MohitSheth10/Rail-Guard/presentations/README.md

# Presentations

This folder contains the presentation material used to explain Rail-Guard.

The main presentation is the project pitch deck: [`Rail-Guard_Pitch_Deck - Final.pptx`](Rail-Guard_Pitch_Deck%20-%20Final.pptx).

It gives the shorter version of the project: the problem, the idea, the prototype, the experiment and what I am trying to find out.
