MohitSheth10/Rail-Guard/media/README.md

# Media

Photos and videos from the Rail-Guard build and testing.

## Folders

- [`photos/`](photos/) — fabrication, electronics, assembly and experiment photos
- [`videos/`](videos/) — testing and prototype videos

This folder is meant to show what the project actually looked like while it was being built, not just the final setup.
