MohitSheth10/Rail-Guard/report/Rail-Guard_Project_Report.docx

RAIL-GUARD

A Vibration-Based Detector for Loose Railway Fishplate Bolts

Project Report

Mohit Sheth · Dhirubhai Ambani International School, Mumbai

IBDP Research and Engineering Project

Everything in this report was actually built, actually soldered, and actually run: a single instrumented rail-fishplate joint, an accelerometer, and a threshold-based frequency-ratio classifier that calls the joint TIGHT or LOOSE from its vibration signature alone. Earlier planning material for this project, proposed in May 2026, sketched a bigger system: multiple sensors, a load cell, GPS tagging, a cloud dashboard. None of that has been built or tested yet; Results and Conclusion covers it as future scope, not as a result. If a claim appears in these pages, hardware ran it and data backs it.

01 · PROBLEM STATEMENT

What is a fishplate?

A fishplate, also called a joint bar, is a flat steel plate bolted across the joint where two rail lengths meet, holding the rail ends in line so a wheel can cross the gap without dropping. A standard joint uses two of them, one on each side of the rail web, four bolts apiece: eight bolts holding the joint together. Let those bolts back off and the two rail ends start moving independently: the gap widens, alignment goes, and every wheel that crosses the joint drifts the joint a little further apart.

On older jointed track, a fishplate joint shows up roughly every 25 metres, about 40 per kilometre. Modern Continuously Welded Rail removes most of them, though they're still common at bridge approaches, level crossings, station throats, and the rural branch lines that never got upgraded.

~68,000 km Indian Railways total route network (2023-24) | 33.89% of 1,024 Indian derailments (2018-21) caused by track defects — CAG, 2022 | ~40/km fishplate joints on standard 25 m jointed track

Why this matters: Track defects are the single largest cause of derailment in India

The Comptroller and Auditor General of India's 2022 performance audit, Report No. 22 of 2022 — Derailment in Indian Railways, examined 1,024 derailments between 2018 and 2021. Track defects caused 347 of them: 33.89%, the largest single category, ahead of human error at 29.79% and rolling-stock failure at 26.56%. Zoom into the 422 cases the audit pinned on the Engineering Department specifically, and "maintenance of track" tops the list at 171 cases, more than any other single reason. That's the target for this project: the most common failure mode on the railway network, and one today's inspection routine cannot catch early.

Why bolts loosen: the physics behind the problem

A bolted joint doesn't need to be struck to loosen; vibration alone does the job. German engineer Gerhard Junker proved this experimentally in 1969: his paper, "New Criteria for Self-Loosening of Fasteners Under Vibration" (SAE Transactions, vol. 78), showed that transverse vibration — load applied sideways across a joint, exactly the direction a passing wheel loads a fishplate — loosens fasteners far more severely than vibration running along the bolt's own axis. The paper is still the reference test mechanical engineers use to rate how vibration-resistant a fastener is, and every train that crosses a joint applies that same sideways load, thousands of times over the joint's life, which is why fishplate bolts loosen at all and a sensor mounted on the joint can pick it up.

How loose bolts are found today

A track inspector, called a Keyman, walks the line carrying a hammer, stopping at every joint to tap each bolt individually. A properly tightened bolt rings; a loose one thuds. On foot, over ballast, in the open, an inspector covers roughly 4–6 km in a shift. The method works, but it's exhaustive rather than targeted: there's no way to know in advance which bolt is loose, so the overwhelming majority checked in a shift turn out to be perfectly fine. On a network the size of India's, one inspector needs weeks to cover even a modest stretch once, and a bolt can start loosening long before that.

What loosening actually looks like — a short clip of the joint on this project's bench rig, shaken by motor-driven vibration with the fishplate bolts progressively backed off, is linked from the project's code and data repository: bolt-loosening-vibration-demo.mp4 (https://github.com/MohitSheth10/Rail-Guard/blob/main/media/videos/bolt-loosening-vibration-demo.mp4)

02 · RESEARCH QUESTION AND HYPOTHESIS

Research question

Can the vibration signature of a bolted rail fishplate joint, captured with a low-cost MEMS accelerometer and analysed in the frequency domain, reliably distinguish a securely tightened joint from one that is not, automatically, without a person inspecting the joint?

Hypothesis

Shake a bolted joint with a repeatable external vibration source, and the way vibration energy splits across frequency bands, specifically the balance between a lower band and a higher band, should differ measurably between a securely tightened joint (3–4 of 4 bolts tight) and one that isn't (0–2 bolts, or no fishplate at all). A loose joint has more freedom to move: that damps the higher-frequency response and pushes energy down into the lower band. A tight joint, more rigidly coupled, does the opposite.

03 · ENGINEERING GOAL

Build a working bench-scale system that:

- Physically reproduces a real bolted fishplate joint under controlled, repeatable vibration — a motor-driven mechanism standing in for a passing train — rather than relying on simulation alone.
- Samples the joint's vibration fast enough, and cleanly enough, to resolve the frequency content that actually matters, not just overall shake strength.
- Finds a single, well-separated numerical threshold that calls a joint TIGHT or LOOSE from that vibration data, validated against a controlled dataset covering every bolt count from 0 to 4, plus a no-fishplate and a stationary baseline.
- Runs that same classification live, on the real-time serial stream from the sensor, with an immediate TIGHT/LOOSE readout — not only after the fact on a saved recording.

This stays a bench-scale prototype, not a deployed railway system. Proving the detection principle on real hardware was the goal, not shipping a field-ready device.

04 · METHODOLOGY

4.1 — Building a real joint to test on

The project built one real bolted fishplate joint rather than simulate one, because no simulation can show whether real hardware, real bolt threads, and real vibration behave the way the theory predicts. Model railway track is moulded plastic, and structural I-beams aren't shaped like a rail either, so the rail sections came from 2-inch mild-steel T-section with a flat plate welded along the top to form the rail head. That weld left the cross-section asymmetric (the top plate is narrower than the base), a detail that turns out to matter for the physics in section 4.2.

The joint sits on a plywood base. A motor-and-cart mechanism provides repeatable, controlled vibration in place of a passing train, so the same event repeats identically across every bolt-count test.

Electronics actually used

- ESP32-S3 Zero as the controller
- MPU-6050/6500 accelerometer reading the joint's vibration
- L298N motor driver, driving the vibration source
- HX711 amplifier and load cell, soldered onto the rig for future bolt-force sensing — wired in, but not yet exercised in the results reported here

Everything was soldered onto perfboard rather than left on breadboard jumpers, because loose jumper wires and a vibration rig do not mix.

Scope note: this build meets the loose-bolt detection goal the project set out to test. One piece stays open: over-tightening detection. The HX711 load cell is soldered onto the rig and waiting on calibration, which is the project's future scope.

4.2 — The physics first: why the original plan didn't work

Before any detection code got written, one question had to be answered first: what frequency does this rail section actually resonate at, and can the sensor even see it? Getting that wrong would have wasted everything that followed, so the physics came before the firmware.

The rail's cross-section is asymmetric, so the standard symmetric I-beam formula doesn't apply: the neutral axis isn't at mid-height. Splitting the section into three rectangles and finding the area-weighted centroid places it 21.4 mm above the bottom, about 7 mm lower than the section's geometric mid-height of 28.4 mm. The second moment of area follows from there: each rectangle sits a different distance from the true centroid, so the parallel-axis theorem applies, giving I = 166,448 mm⁴.

λ² _________________

f = ───── × √ EI / (m·L⁴)

2π

For mild steel (E = 200 GPa, ρ = 7,850 kg/m³), across the spans and end conditions relevant to this rig, that works out to a fundamental natural frequency somewhere between roughly 168 Hz (the whole 609.6 mm track, cantilevered) and about 38 kHz (a single 101.6 mm sleeper-to-sleeper span, clamped at both ends). The most physically realistic case, the whole track simply supported, lands around 470 Hz.

That range mattered because the MPU's accelerometer samples at 1,000 Hz maximum. By the Nyquist limit, it can resolve frequencies only up to about 500 Hz, and realistically less. Almost every case in that range sits above what the sensor can actually see. Pointing an FFT at the rail's own ringing frequency would have meant either seeing nothing real, or aliasing: a plausible-looking low frequency with no physical meaning behind it.

That finding redirected the whole approach: instead of watching for a shift in the rail's own resonant frequency, the target became the joint itself, the fishplate, bolts, and base moving together as a much heavier, much lower-frequency system. A loose bolt doesn't change the stiffness of the steel rail; it changes how the two rail ends move against each other, and that's a low-frequency signal a 1 kHz accelerometer can resolve without trouble, which is what every step from here builds on.

4.3 — The code, step by step

The firmware and analysis tools were built incrementally, each one solving the specific problem the previous one exposed, ending at the live tool this project currently runs.

Step | File | What it solved
1 | MPU_Test.ino | First proof the sensor was talking to the board, and confirmed its real identity: an MPU-6500 sold under the MPU-6050 name, which needed its own register configuration.
2 | mpu6050_1khz_stream.ino | Correct 1 kHz sampling: moved the sensor to its final wiring, configured the correct MPU-6500 registers, and used an absolute-deadline scheduler so every sample lands within microseconds of its ideal interval.
3 | daq.py | Gets the stream onto a computer — opens the serial port, auto-detects the column count, writes a timestamped CSV.
4 | fft_analysis.py | Turns raw samples into frequency content — trims to the vibrating segment, runs a windowed FFT, reports energy by frequency band.
5 | classify_tightness.py | Applies the tuned 30–60 Hz / 60–100 Hz ratio (section 4.4) to call a reading TIGHT or LOOSE.
6 | statistical_analysis.py | Checks the separation is a real, group-level effect — ANOVA, Kruskal-Wallis, and pairwise tests across every bolt count.
7 | liveclassifytightness.py | The current, final tool: reads the live serial stream, keeps a rolling 2-second window, and re-runs the same tuned classification twice a second in an on-screen GUI.

4.4 — The differentiator: a frequency-band ratio, not raw loudness

The most important decision in this project's methodology was which number to pull out of the FFT and threshold on. Three candidates went up against the full dataset, and two failed:

- Overall vibration loudness (RMS) alone is not reliable. A completely missing fishplate can read about as quiet as a properly tightened joint.
- "Which single frequency is loudest" is not reliable either. Most readings contain two frequencies close in strength, and which one comes out marginally louder can flip between otherwise-identical readings.
- What holds up: the ratio of vibration energy in the 30–60 Hz band to energy in the 60–100 Hz band.

ratio = (energy in 30–60 Hz band) / (energy in 60–100 Hz band)

A securely tightened joint is more rigidly coupled and puts most of its shake into the faster ~79 Hz component, so this ratio comes out low. A joint that isn't properly secured has more freedom to move: that damps the higher-frequency response and leaves relatively more energy in the slower ~39 Hz component, so the ratio comes out high. Raw loudness and a single peak frequency both failed the test, which is why that bandwidth ratio is what the whole detection system is built on.

4.5 — A mounting fix along the way

The plywood base itself was shifting slightly under its own vibration, so part of what the sensor picked up was rig movement, not the joint. Clamping the board down on 29 August fixed it, and every reading used in the results below was collected after that.

05 · OBSERVATION

Once the board-drift bug was fixed, the controlled dataset came together: 0, 1, 2, 3, and 4 bolts tight, plus a no-fishplate condition and a stationary motor-off baseline, three repeats each.

Condition | Ratio range observed | Verdict
4 bolts tight | 0.175 – 0.278 | TIGHT
3 bolts tight | 0.285 – 0.298 | TIGHT
2 bolts tight | 0.386 – 0.466 | LOOSE
1 bolt tight | 0.498 – 0.645 | LOOSE
0 bolts tight / no fishplate | 1.384 – 5.592 | LOOSE

- Every 3–4 bolt (secure) reading scored below 0.30. Every not-secure reading (0–2 bolts, or no fishplate) scored above 0.38 — a clean gap, with the working threshold set at 0.35, in the middle of it.
- Vibrating readings consistently scored well above ~6,000 RMS; a stationary, motor-off reading scored around 36 RMS. Three orders of magnitude apart, plenty of room for a simple RMS floor to flag "not enough vibration to judge" before any TIGHT/LOOSE call gets attempted.

The statistical check confirms the separation is real and group-level, not coincidence, though it's honest about what only three repeats per bolt count can prove: with n = 3 per group, a pairwise Mann-Whitney U test mathematically cannot clear a p-value of 0.1, however separated the groups actually are — a limit of the sample size, not of the method. The overall pattern makes the stronger case anyway: group means ordered 0 > 1 > 2 > 3–4, with little to no overlap in ranges.

Fine-grained bolt counting — telling 3 tight apart from 4 tight, specifically — is noticeably less reliable than the binary TIGHT/LOOSE call: the observed ranges for those two states (0.285–0.298 vs. 0.175–0.278) almost overlap, so the classifier reports them together as a combined "3–4 bolts tight" bucket rather than guessing which one it is.

06 · RESULTS AND CONCLUSION

The hypothesis holds: the ratio of vibration energy between the 30–60 Hz and 60–100 Hz bands reliably separates securely tightened rail-joint bolts from joints that aren't secure, and the working threshold of 0.35 has correctly classified every reading collected to date, whether run offline on saved captures or live on the sensor's real-time stream. That meets the project's engineering goal: a single instrumented joint, detecting loose fishplate bolts automatically, from vibration alone, live and on demand.

One open boundary

The 3-vs-4-tight boundary sits closer together than the rest of the scale (0.285–0.298 vs. 0.175–0.278) and would benefit from more repeat readings before it's trusted at that resolution. The binary TIGHT/LOOSE call is the project's core result, and it isn't affected.

Status

Part | Status
ESP32-S3 controller | Tested
MPU accelerometer | Tested, sampling verified at 1 kHz
Motor + L298N driver | Tested — vibration source confirmed across every capture
Natural-frequency calculation | Done — the result that redirected the whole approach
Board-drift systematic error | Found and fixed (29 August)
Controlled dataset | Collected: 0–4 bolts tight, no-fishplate, stationary baselines, 3 reps each
FFT + tight/loose analysis | Built and statistically checked against the full dataset
Fine-grained bolt count (3 vs 4 tight) | Works; resolution close — more repeats would firm it up
Live real-time detection | Built and working
HX711 + load cell (over-tightening detection) | Soldered, not yet calibrated — the project's future scope

Scope and limits

This stays a bench-scale prototype, validated on one instrumented joint under motor-driven vibration rather than a moving train. Over-tightening detection through the HX711 load cell is wired and soldered; calibrating and testing it is the one piece of the original design still open, and the project's future scope.

Sources

Comptroller and Auditor General of India, Report No. 22 of 2022 — Performance Audit on Derailment in Indian Railways, 2022.

Junker, G. H., "New Criteria for Self-Loosening of Fasteners Under Vibration," SAE Transactions, vol. 78, 1969, pp. 314–335.

Indian Railways route network figures — official Ministry of Railways annual statistics, 2023–24.

Full source code, capture data, and build documentation: github.com/MohitSheth10/Rail-Guard
