MohitSheth10/Rail-Guard/hardware/track_3d_model.html

## Rail-Guard Track — 3D Design (v3)

Drag to rotate · scroll to zoom · right-drag to pan. Yellow labels in the scene show real lengths.

### Confirmed by you

- Each rail = 2 I-section pieces, 12in (1ft) each = 24in (2ft) total track length
- Web height: 2 in · Bottom flange width: 2 in
- Top flange (cart rides here): 2.1 cm ≈ 0.83 in
- Fishplate: 4 in long, as thin as possible
- Sleeper spacing: ~4 in (a bit more/less is fine)
- Gauge (distance between the 2 rails): 4.25 in
- Bolts: 4 in a single horizontal line, in pairs (. . . .), gap in the middle reserved for the MPU sensor mount (green outline)

### Still assumed — please confirm

- Flange thickness: assumed 0.12 in (~3mm)
- Web thickness: assumed 0.1 in (~2.5mm)
- Fishplate thickness: assumed 0.06 in (~1.5mm, thinnest practical sheet steel)
- Fishplate height: assumed 1.8 in (slightly less than web height)
- Motor compartment (70x50x50mm box) is illustrative only

Rail-Guard — track design v3
