MohitSheth10/Rail-Guard/presentations/Rail-Guard_Pitch_Deck - Final.pptx

RAIL-GUARD

A Vibration-Based Detector for Loose Railway Fishplate Bolts

Bench-scale prototype · built and tested on real hardware

Mohit Sheth · Dhirubhai Ambani International School, Mumbai
IBDP Research and Engineering Project · IRIS / INSEF Submission
Updated September 2026

## Slide 2

01 · PROBLEM

A fishplate joint can loosen — and nobody knows until it fails

A fishplate (joint bar) bolts two rail ends together, 4 bolts per side, 8 per joint. Let those bolts back off and the rail ends move independently under every wheel that crosses. Trains loosen them through vibration alone: Junker's 1969 research found that transverse vibration, exactly the load a passing wheel applies, self-loosens bolted joints far more severely than vibration running along the bolt's own axis.

8

bolts hold each fishplate joint together

~40/km

fishplate joints on standard 25 m jointed track

33.89% of the 1,024 derailments India's Comptroller and Auditor General examined (2018–21) were caused by track defects — the single largest category, ahead of human error (29.79%) and rolling-stock failure (26.56%). Within the cases attributed to the Engineering Department, "maintenance of track" was the leading cause of all.

Source: Comptroller and Auditor General of India, Report No. 22 of 2022 — Derailment in Indian Railways.

Rail-Guard — Project Report Deck

2

## Slide 3

01 · PROBLEM

Checking every bolt to find the few that matter

A track inspector, called a Keyman, walks the line with a hammer, tapping every bolt at every joint by hand. A properly tightened bolt rings; a loose one thuds. The method works, but there's no way to know in advance which bolt is loose, so almost every one checked in a shift turns out fine.

Rail-Guard's goal: replace hand-tapping every bolt with a sensor that reads the joint's own vibration and calls it TIGHT or LOOSE automatically.

What loosening actually looks like — bench rig under motor-driven vibration

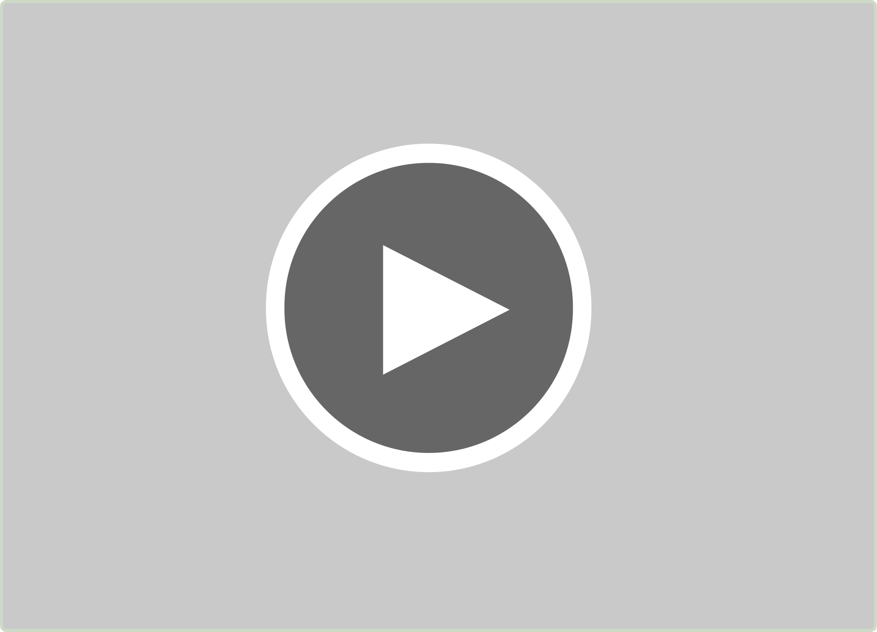
[picture p6: figure]

~68,000 km

Indian Railways total route network (2023–24)

Rail-Guard — Project Report Deck

4–6 km

covered per inspector, per shift, on foot

3

## Slide 4

02 · RESEARCH QUESTION

Research question

Can the vibration signature of a bolted rail fishplate joint, captured with a low-cost MEMS accelerometer and analysed in the frequency domain, reliably distinguish a securely tightened joint from one that is not, automatically, without a person inspecting the joint?

Hypothesis

A loose joint has more freedom to move: that damps the higher-frequency response and pushes relatively more vibration energy into the lower-frequency band, while a tight joint, more rigidly coupled, does the opposite — which is why the balance of energy between a low band and a high band should separate TIGHT joints from LOOSE ones.

Engineering goal: build a bench-scale system that physically reproduces a real bolted joint under controlled vibration, finds a single numerical threshold that separates TIGHT from LOOSE, and runs that classification live on real hardware, as it happens.

Rail-Guard — Project Report Deck

4

## Slide 5

03 · THE BUILD

One real joint, built to actually test the theory

The track section came from 2-inch mild-steel T-section, since model track and structural I-beams don't match a real rail's shape, with one real bolted fishplate joint. A motor-and-cart rig stands in for a passing train, providing repeatable vibration.

Electronics actually used

Scope note

This build completes the loose-bolt detection goal the project set out to test.

The one piece still open: over-tightening detection. The HX711 load cell is soldered onto the rig but not yet calibrated — the project's future scope.

- ESP32-S3 Zero — controller

- MPU-6050/6500 accelerometer — reads joint vibration

- L298N motor driver — drives the vibration source

- HX711 + load cell — soldered in for future bolt-force sensing, not yet exercised in these results

Rail-Guard — Project Report Deck

5

## Slide 6

04 · METHOD

The differentiator: a frequency-band ratio, not raw loudness

Overall vibration loudness isn't reliable, since a missing fishplate can read as quiet as a tight one, and the single loudest frequency isn't reliable either. What holds up: the ratio of vibration energy in a lower band to a higher band.

ratio = (energy in 30–60 Hz band) / (energy in 60–100 Hz band)

A securely tightened joint is more rigidly coupled and puts most of its shake into the faster ~79 Hz component, so the ratio comes out low. A joint that isn't secure has more freedom to move: that damps the higher-frequency response and leaves more energy in the slower ~39 Hz component, so the ratio comes out high.

Mounting fix along the way: the plywood base was shifting under its own vibration. Found and fixed on 29 August; every reading used in the results shown here was collected after that fix.

Rail-Guard — Project Report Deck

6

## Slide 7

05 · RESULTS

A clean separation between TIGHT and LOOSE

Condition | Ratio range observed | Verdict
4 bolts tight | 0.175 – 0.278 | TIGHT
3 bolts tight | 0.285 – 0.298 | TIGHT
2 bolts tight | 0.386 – 0.466 | LOOSE
1 bolt tight | 0.498 – 0.645 | LOOSE
0 bolts / no fishplate | 1.384 – 5.592 | LOOSE

Honest limit: with only 3 repeats per bolt count, a pairwise significance test can't mathematically clear p < 0.1, however separated the groups actually are — a limit of the sample size, not of the method. The group means still order cleanly: 0 > 1 > 2 > 3–4, with little to no overlap in ranges.

Working threshold

0.35

Every 3–4 bolt reading scored below 0.30; every 0–2 bolt (or no-fishplate) reading scored above 0.38 — a clean gap, with the threshold set in the middle of it.

Rail-Guard — Project Report Deck

7

## Slide 8

06 · STATUS

Goal met, with one boundary still open

Result

The core TIGHT/LOOSE distinction, live, on real hardware, across every bolt count from 0 to 4 plus a no-fishplate condition, with a clean statistical gap. The project's engineering goal is met.

One open boundary

The 3-vs-4-tight boundary sits closer together than the rest of the scale and would benefit from more repeats. The binary TIGHT/LOOSE call is the project's core result, and it isn't affected.

Part | Status
ESP32-S3 + MPU accelerometer | Tested, live at 1 kHz
Natural-frequency calc + board-drift fix | Done — redirected the approach; fixed 29 Aug
FFT + tight/loose ratio classifier | Built, statistically checked, running live
HX711 + load cell (over-tightening) | Soldered, not yet calibrated — future scope

Rail-Guard — Project Report Deck

8

## Slide 9

Rail-Guard detects loose fishplate bolts, live, on real hardware.

Bench-scale prototype, single instrumented joint, threshold-based frequency-ratio detection — built, tested, and running.

Thank you

Full source code, capture data, and build documentation:
github.com/MohitSheth10/Rail-Guard

Sources: CAG Report No. 22 of 2022 · Junker (1969), SAE Transactions vol. 78 · Indian Railways route network statistics, 2023–24.
