MohitSheth10/Rail-Guard/hardware/track_drawings.pdf

# Rail-Guard Track Dimensioned Drawing Pack (v4)

All confirmed lengths are in inches/cm as you gave them; converted to mm for drawing

CONFIRMED BY YOU
- Each rail = 2 I-section pieces, 12 in (1 ft) each -> 24 in (2 ft) total track length
- Web height: 2 in | Bottom flange width: 2 in
- Top flange (cart rides on this): 2.1 cm (about 0.83 in)
- Fishplate: 4 in long, as thin as possible (thickness ~1.5mm, height ~1.8in)
- Sleeper spacing: about 4 in (a little more/less is fine)
- Gauge (distance between the 2 rails): 4.25 in
- Bolts: M6 - 6mm shaft, 10mm hex head (spanner size), shown separately on page 4
- Motor compartment (70x50x50mm) is an optional addition, illustrative only

STILL ASSUMED - PLEASE CONFIRM
- Flange thickness: assumed 0.12 in (~3mm)
- Web thickness: assumed 0.1 in (~2.5mm)

PAGES IN THIS PACK
2. Top view (plan) - with lengths
3. Front elevation - with lengths
4. Joint detail (fishplate + M6 bolts, zoomed) - with lengths, spanner vs shaft shown separately
5. Isometric reference view - with lengths

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

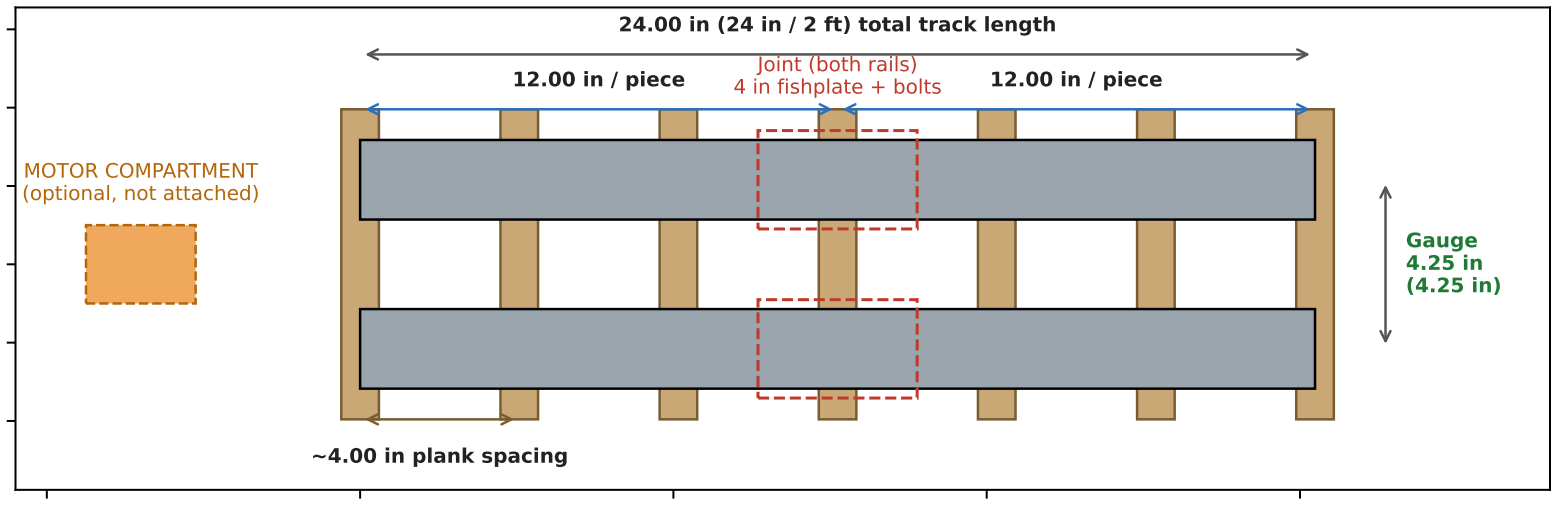
[picture p7: figure]

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

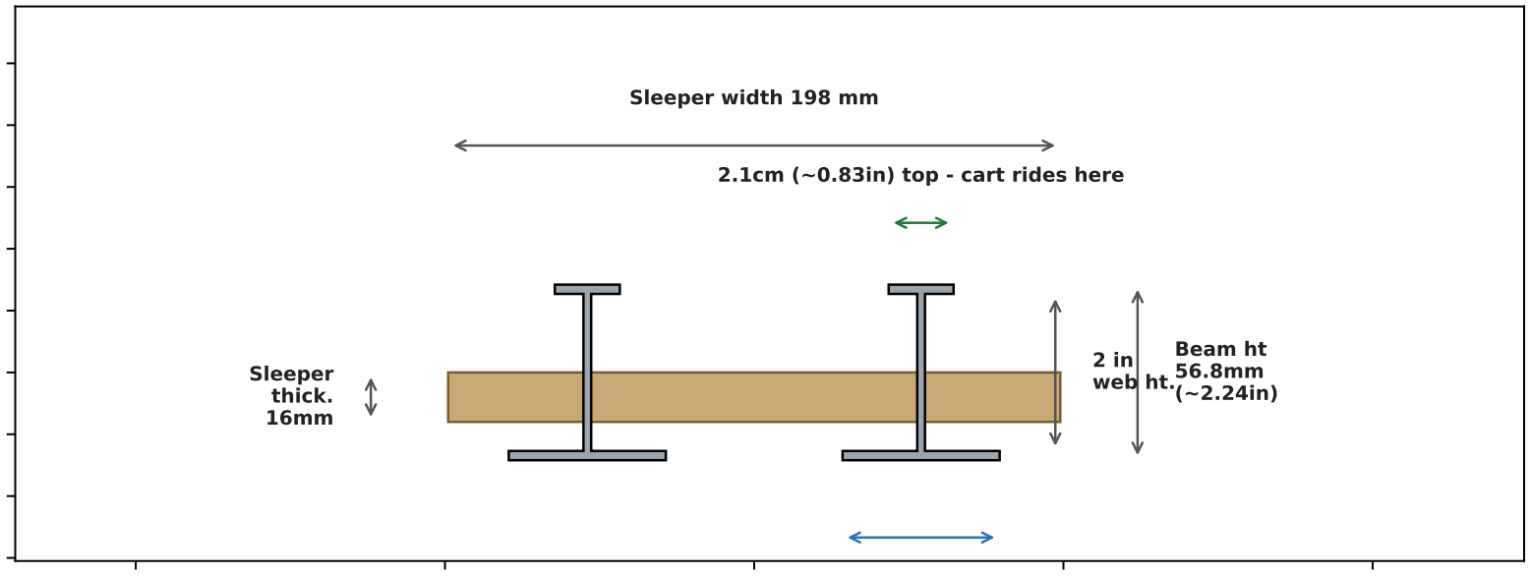
[picture p8: figure]

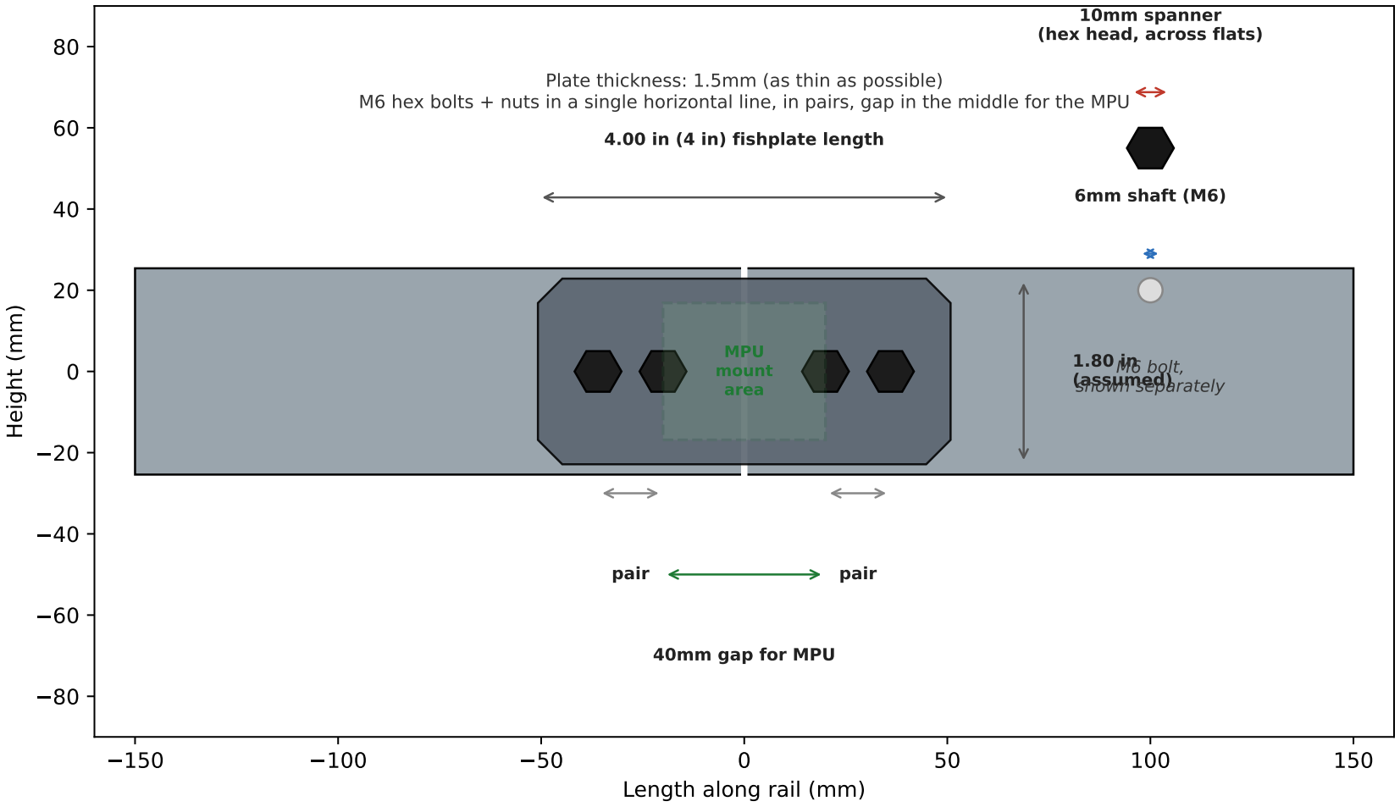
[picture p9: figure]
Length along rail (mm); Height (mm); 4.00 in (4 in) fishplate length; 1.80 in (assumed); pair; 40mm gap for MPU; 10mm spanner (hex head, across flats); 6mm shaft (M6); M6 bolt, shown separately; MPU mount area

Plate thickness: 1.5mm (as thin as possible) M6 hex bolts + nuts in a single horizontal line, in pairs, gap in the middle for the MPU

## JOINT DETAIL realistic fishplate + M6 hex bolts (zoomed, one rail)

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

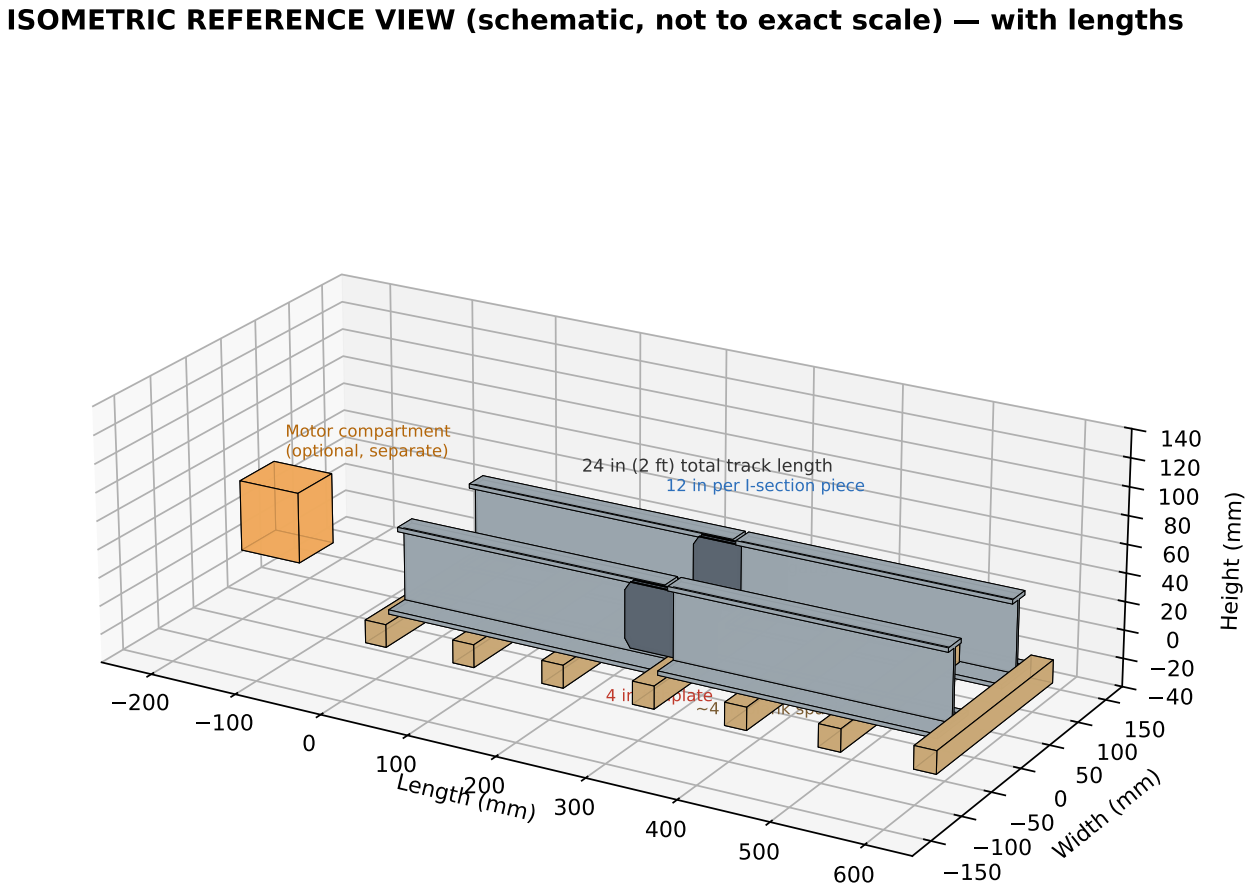
[picture p10: page 5]
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
