MohitSheth10/Rail-Guard/hardware/schematic/Project Schematic.pdf

## r6 '~~ ~owar ~~oi!(

~

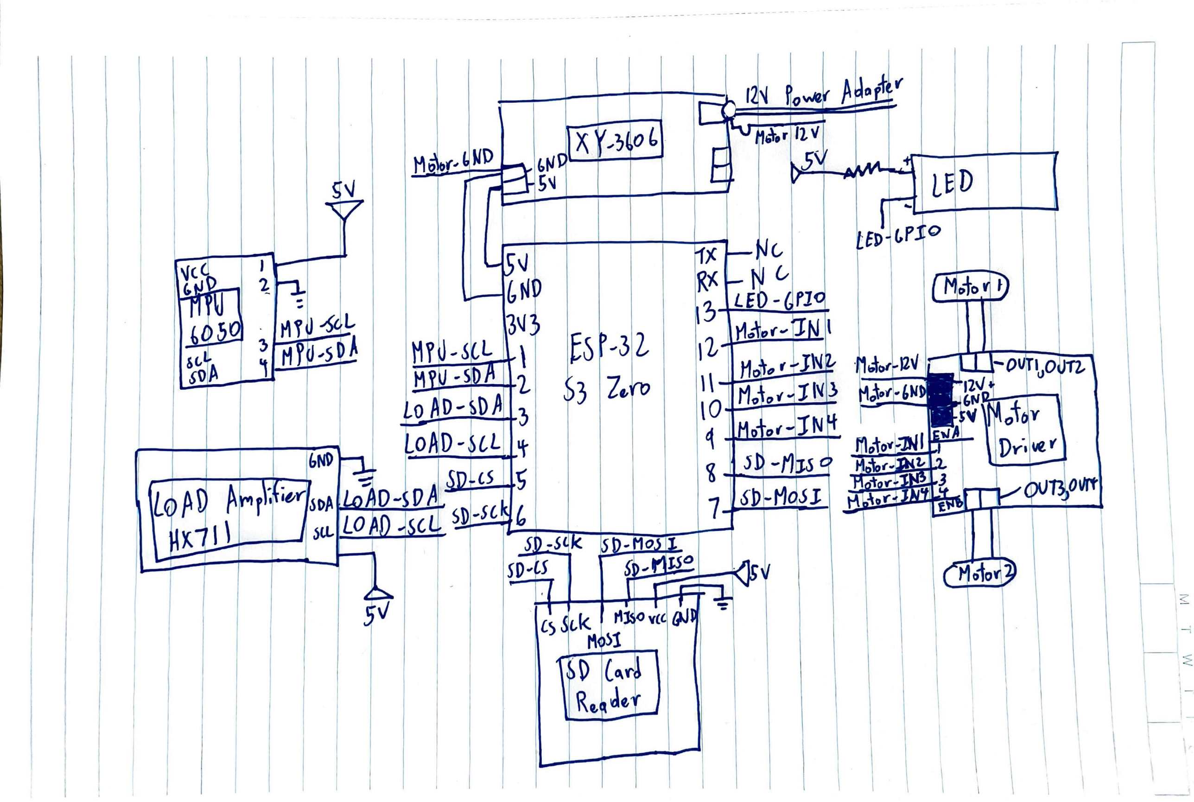
[picture p11: page 1]

I | I

# H.~r-f ~ttJd[X YJ7!0 lj

I s~

## a b.l-.rlllV

~i ~ 1 .~ LJD 1 | 1 | r ...
I | ~'-----"'- | \J | ~t | tJc., - | u.---1 {, | R,c Nl (,
~...-, ~ ~----r-L. | J\J | I?} LEb -G Pl C
I | i | A | ---+---+-""_,.,..\ | fS J3 2, | I 1 t1J .. ,-tJN II
.;..:.J-j-~..:....U,.i | z | '1 ( .11 | • | .___......- | l
, | - t) | 3 " | I\ | t I | 1-....--- | - OVirt,OUft.
I | -;--+-+-+--~ | I | J | I O | '-, | r-.:.--~ | fJ ~ I
II | -r---+-:-~~ | oAD-, lL it | ~ , 1 | ......,_... ot v
ii ,L ~~ ~ r •IA"~.,,.~~~ ics ~ | i | nb :::::.~ vy·,vet
~ I \ | ,51.L I | SD -5l ..,,,,......;___i_ | .l:..,l~~ | 7 6))-M s J :;:~~~~',_ | <pV~O~

1

# tEsi~ c,pjo

~fo.~~

/ / . | ~ | so~ ~,___.i~~-t---r
·(c~ t,k | ~
M ~l

# ~o c~r~

# R" Jer j

- | I | I
I
| | I
I I
I | I I I
I | I | I
I I | I I | I
I | I I

I

I

I

I | I
~~ | I I I I | Qfo1o~

\

# l I I

I I
I I
I | I
I \ ~ \ I
\ I \ \ | I | \

\

I I

I i.

I

\
\
I
I

\

I
I | '<
| -i
| ~
