MohitSheth10/Rail-Guard/code/Inaccurate Readings/capture_vibrating2_plot.png

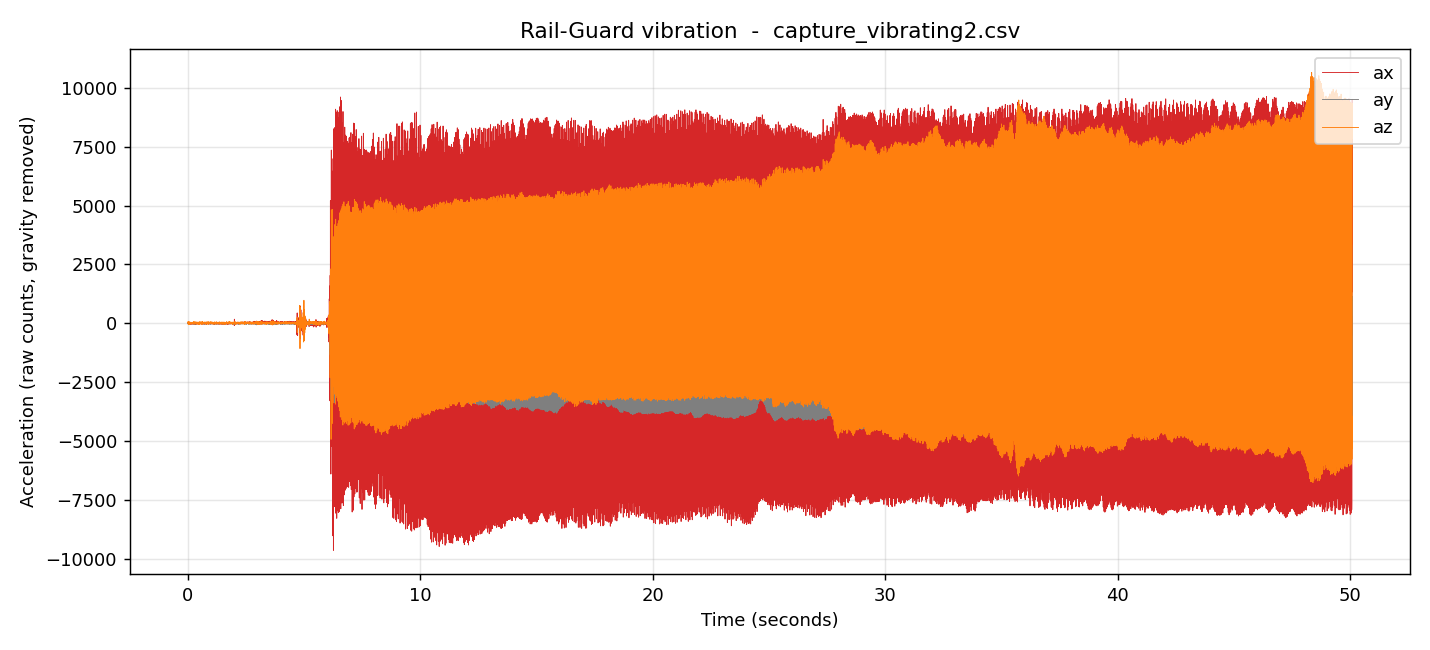
code/Inaccurate Readings/capture_vibrating2_plot.png
