MohitSheth10/Rail-Guard/code/Inaccurate Readings/vibrating2_corrected_plot.png

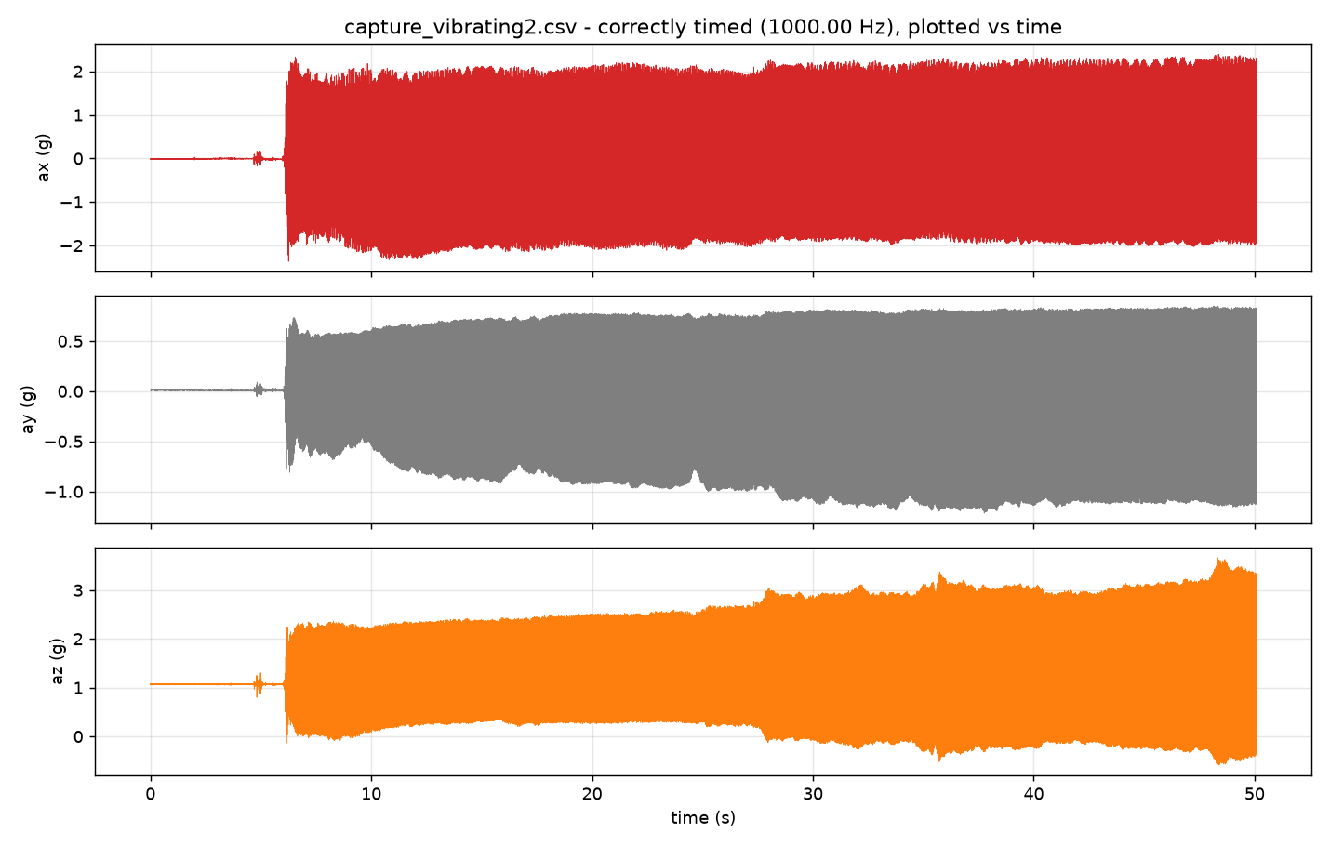
code/Inaccurate Readings/vibrating2_corrected_plot.png
