MohitSheth10/Rail-Guard/code/Inaccurate Readings/vibrating4_diagnostic_plot.png

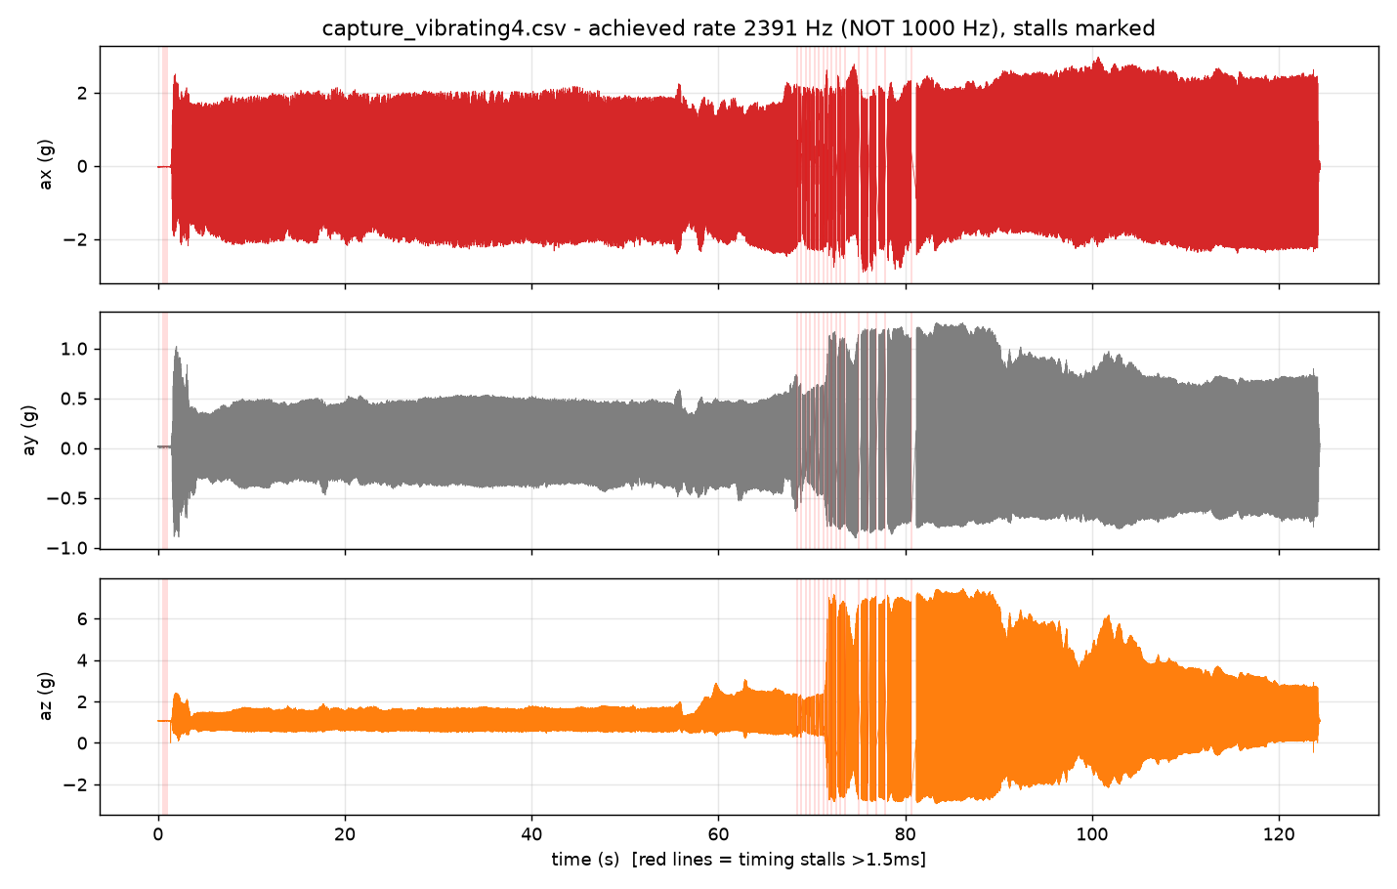
code/Inaccurate Readings/vibrating4_diagnostic_plot.png
