MohitSheth10/Rail-Guard/hardware/schematic/Updated Schematic.jpg

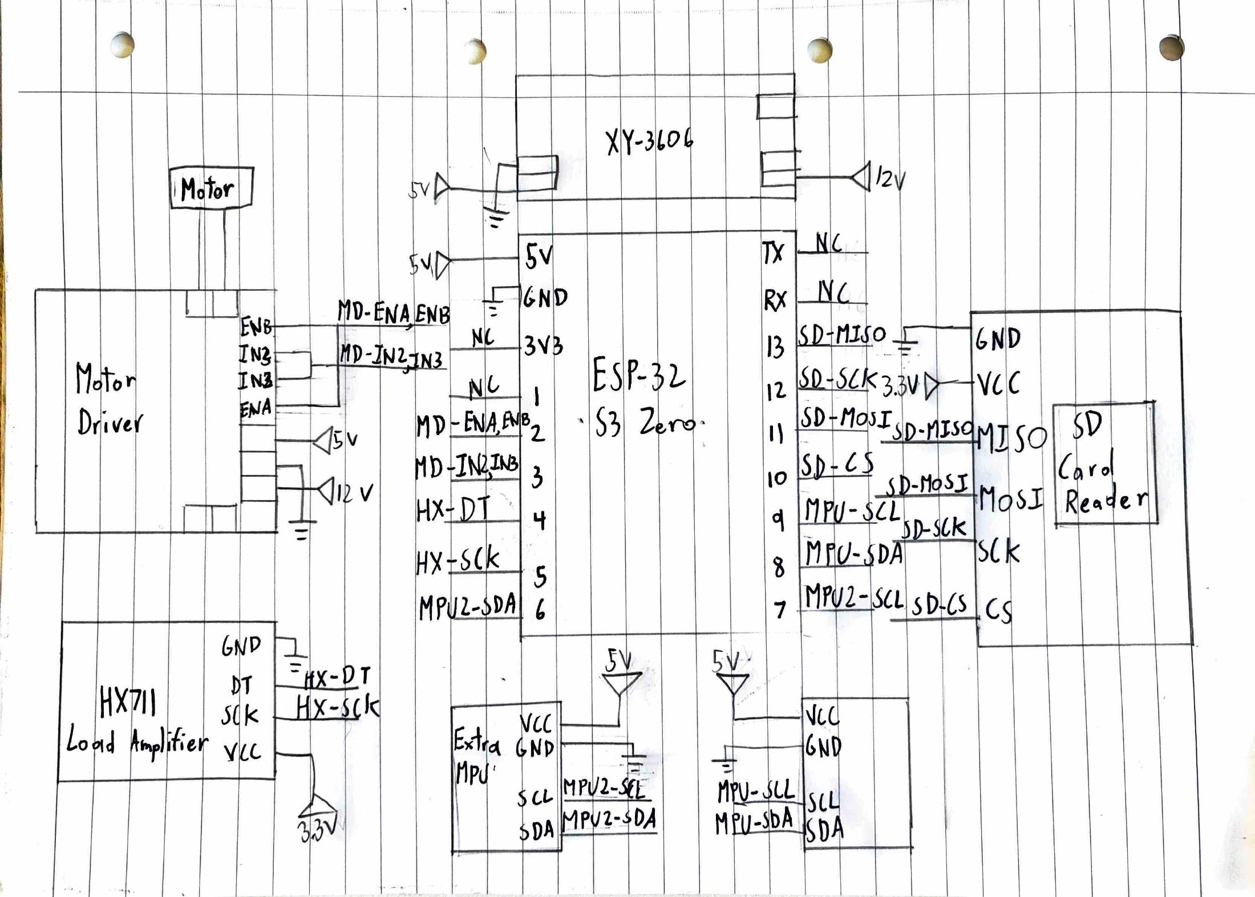
hardware/schematic/Updated Schematic.jpg
