MohitSheth10/Rail-Guard/media/analysis_rms_by_state.png

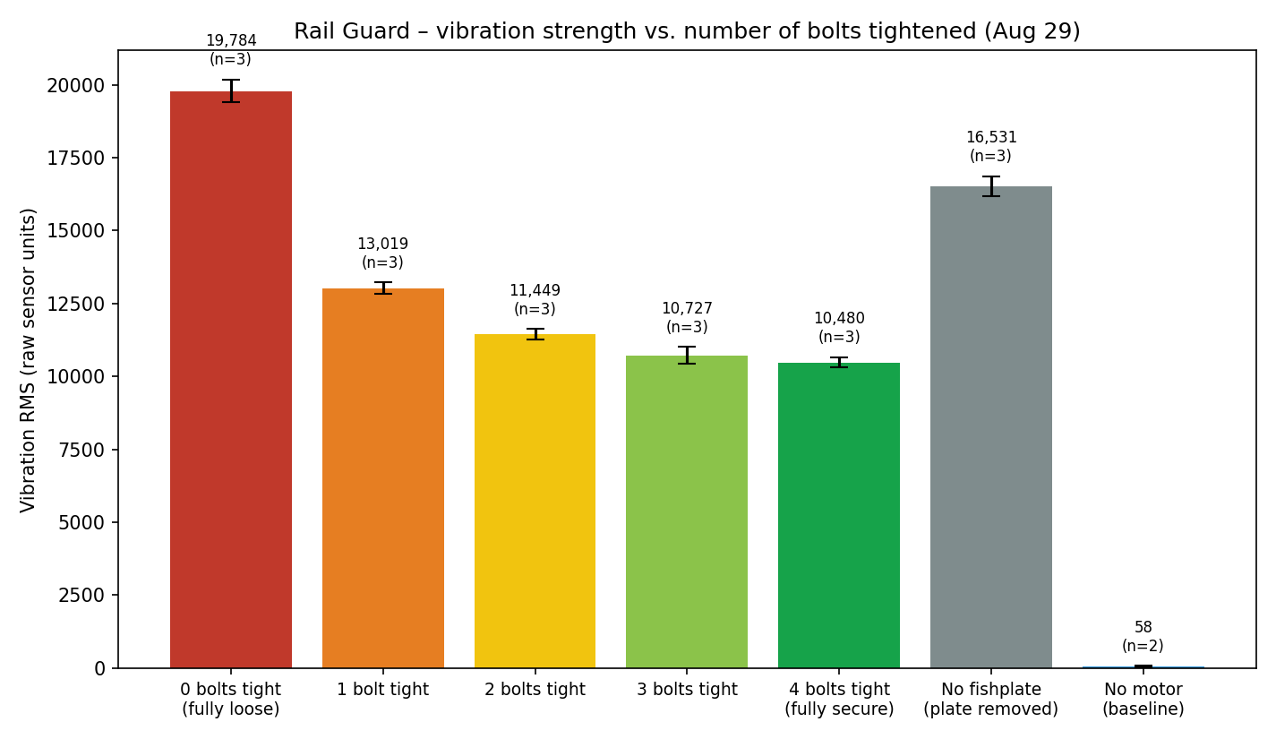
media/analysis_rms_by_state.png
