MohitSheth10/Rail-Guard/media/rig-photo.jpg

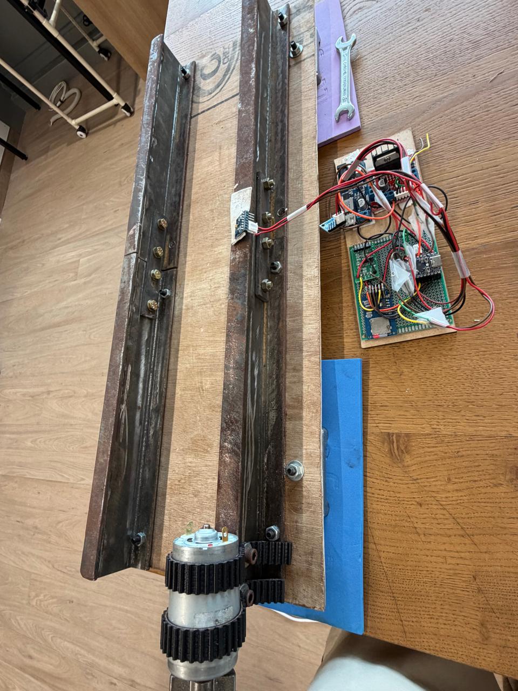
media/rig-photo.jpg
