MohitSheth10/Rail-Guard/hardware/RailGuard_BOM_AsBuilt.xlsx

RAIL-GUARD - AS-BUILT BILL OF MATERIALS
Only components physically in the final build. For every part considered/purchased, see the Full BOM.
# | Component | Category | Qty Used | Unit Price (Rs) | Total (Rs) | Source
SENSING & PROCESSING
A1 | ESP32-S3 Mini Module | Electronics | 1 | 604 | 604 | robu.in
A2 | MPU6050/6500 (GY-521) Accelerometer/Gyro Module | Electronics | 1 | 209 | 209 | amazon.in
A4 | MicroSD Card Module (SPI) | Electronics | 1 | 110 | 110 | amazon.in
A5 | SanDisk 32GB Class 10 MicroSD Card | Electronics | 1 | 929 | 929 | amazon.in
A6 | 3Kg Load Cell (weighing sensor) | Electronics | 1 | 127 | 127 | Robobazaar
A7 | BX350-3AA Strain Gauge (Full Bridge) | Electronics | 4 | 64 | 256 | robu.in
A8 | HX711 24-bit Weight Sensor ADC | Electronics | 1 | 42 | 42 | robu.in
OUTPUT
B1 | 10mm High-Brightness LED | Output | 1 | 81 | 81 | robu.in
B2 | Resistor (from pack) | Output | 1 | 199 | 199 | amazon.in
POWER
C2 | 12V/24V to 5V 5A DC-DC Module (XY-3606) | Power | 1 | 125 | 125 | zbotic.in
V3 | LTRONIX 12V 2A DC Power Adapter | Power | 1 | 485 | 485 | amazon.in
MOTOR / VIBRATION SOURCE
V1 | Sector 775 DC12V 4000RPM Vibration Motor (w/ vibrating head) | Motor | 1 | 875 | 875 | robu.in
V2 | L298N 2A Motor Driver Module | Motor | 1 | 123 | 123 | robu.in
WIRING & ASSEMBLY
D3 | Hot Glue Sticks 7mm | Assembly | 1 | 73 | 73 | amazon.in
D4 | Flux Pen | Assembly | 1 | 800 | 800 | amazon.in
D5 | Solder Wire | Assembly | 1 | 253 | 253 | robu.in
D6 | Micro-USB Cable 1m | Assembly | 1 | 39 | 39 | robocraze.com
D7 | F-F DuPont Jumper Cables (40pc) | Assembly | 1 | 40 | 40 | robu.in
D8 | M-M Jumper Wires (40pc) | Assembly | 1 | 44 | 44 | robu.in
D9 | M-F Jumper Wires (10-wire) | Assembly | 1 | 14 | 14 | robu.in
D10 | GL12 840-Point Breadboard | Assembly | 1 | 70 | 70 | amazon.in
D11 | Hook-Up Wire Packet (5 colors) | Assembly | 1 | 145 | 145 | amazon.in
-- | Green Perfboard ~15x15cm | Assembly | 1 |  |  | From classmate
-- | Male Headers (berg strip) | Assembly | 6 |  |  | robu.in
-- | Female Headers | Assembly | 6 |  |  | robu.in
-- | Twisted Pair Wire, 5m | Assembly | 1 |  |  | -
TRACK & PHYSICAL STRUCTURE
E1 | Aluminum Angle Section 25x25x2mm (Rails) | Track | 2 |  |  | Local hardware store
E2 | MDF Board 600x300x9mm (Baseboard) | Track | 1 |  |  | Local carpenter
E3 | Wooden Strips - Sleepers (20x10x200mm) | Track | 15 |  |  | Local timber shop
E4 | Mild Steel Flat Bar 50x4mm (Fishplates) | Track | 1 |  |  | Local steel shop
E5 | M5 Hex Bolts + Nuts + Washers (40pcs) | Track | 40 |  |  | Local hardware store
E6 | Acrylic Sheet 200x150x3mm (unconfirmed - verify if used) | Track | 2 |  |  | Not yet purchased?
 |  |  |  | TOTAL (confirmed prices): | 5643
