MohitSheth10/Rail-Guard/media/photos/Soldering Iron.jpeg

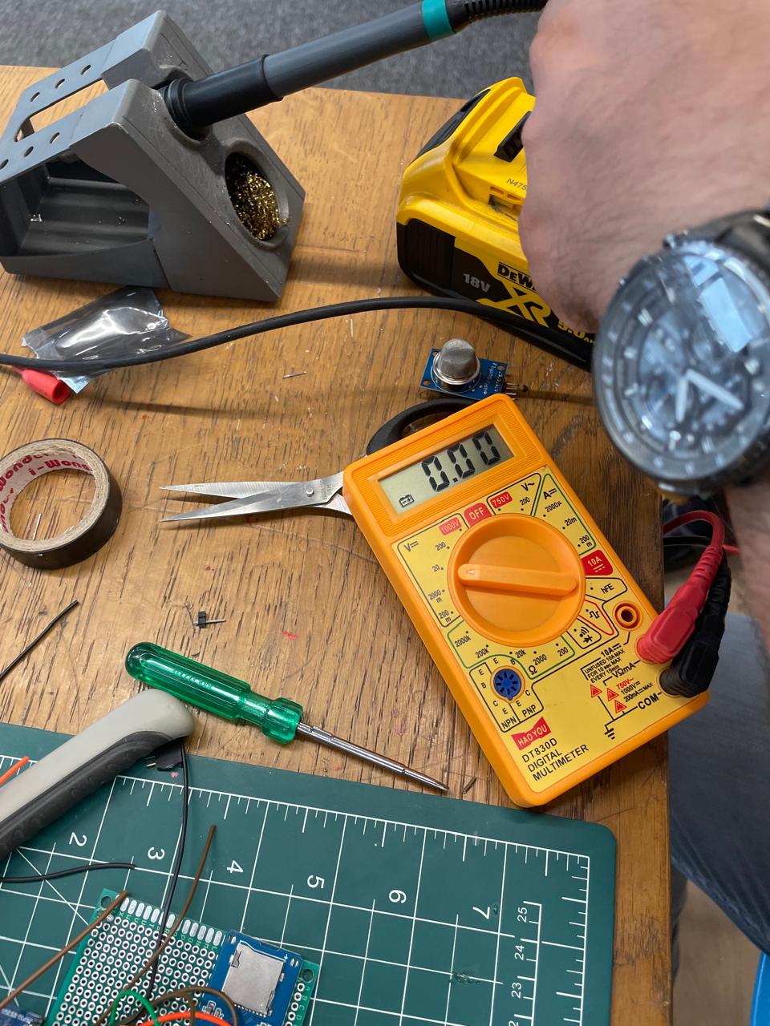
media/photos/Soldering Iron.jpeg
