MohitSheth10/Rail-Guard/media/photos/Track Setup for Data Recording.jpeg

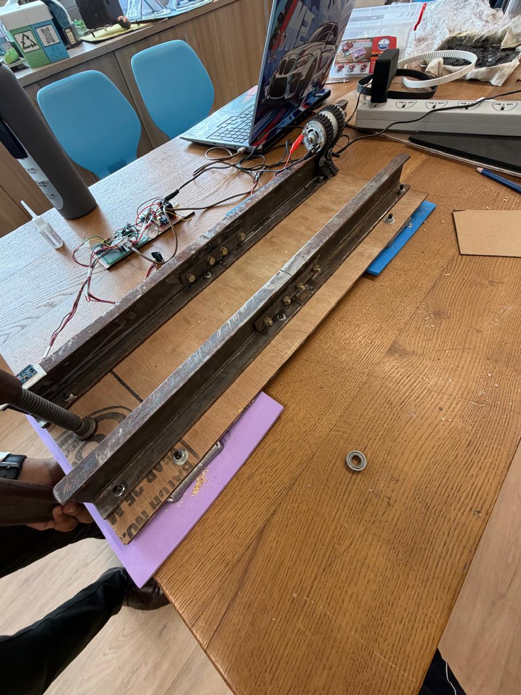
media/photos/Track Setup for Data Recording.jpeg
