MohitSheth10/Rail-Guard/hardware/schematic/Final Schematic.pdf

R

a

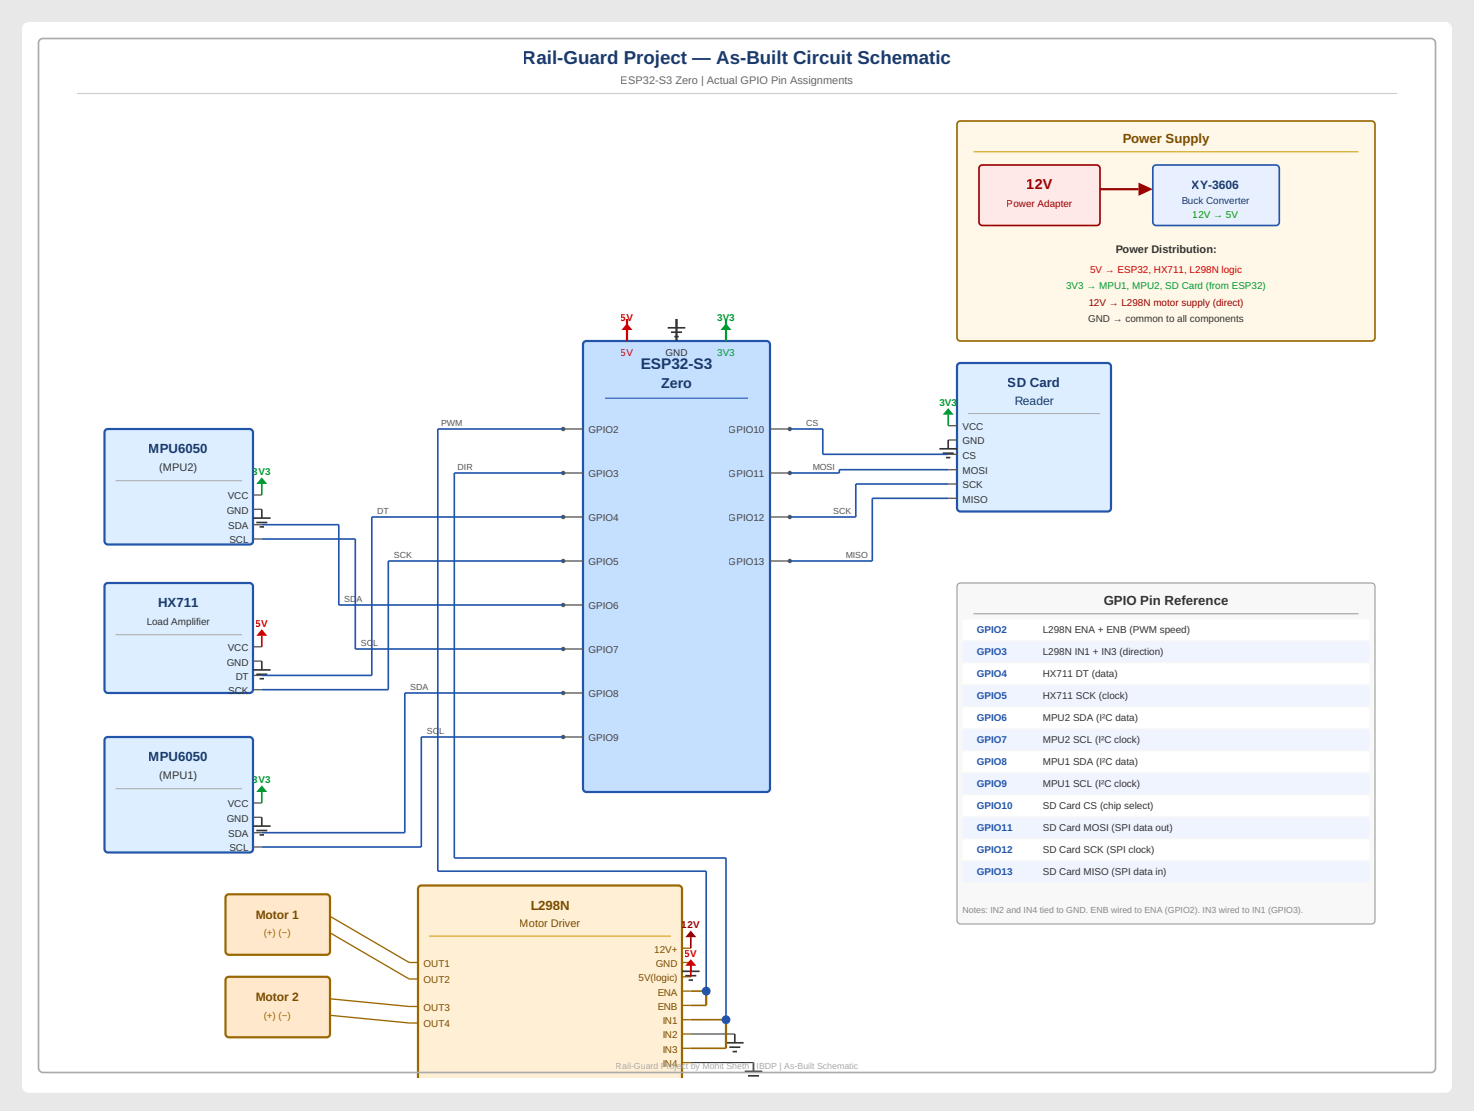
[picture p22: page 1]
PIO; Pin; sig; plifie; riv; gic; MDIR; SIS; KMIS; ply; dir; all c; tio; clo; hip; ele; PI clo; MIS; tie; wir

SI SCK MISO

). Rail-Guard Project by Mohit Sheth | IBDP | As-Built Schematic
