MohitSheth10/Rail-Guard/(commit log)

2026-06-28 Add schematics and circuit photos
2026-06-28 Add pitch deck
2026-08-22 first file
    [capture_loose1.csv]
2026-08-22 Make a new folder called Readings
    [capture_loose1.csv]
2026-08-22 Add capture_vibrating2.csv file
    [capture_vibrating2.csv]
2026-08-22 Rename Media2.jpeg to Soldering Iron.jpeg
2026-08-29 Move pre-clamp readings to Inaccurate Readings; add Accurate Readings folder for clamped-board experiment
    [capture_vibrating4.csv]
2026-08-29 Move more inaccurate readings (batch 2)
    [capture_vibrating10.csv, capture_vibrating8.csv]
2026-08-29 Move more inaccurate readings (batch 3)
    [capture_stationary1.csv, capture_stationary2.csv, capture_stationary3.csv, capture_vibrating1.csv, capture_vibrating2.csv, capture_vibrating3.csv, capture_vibrating5.csv]
2026-08-29 Move remaining inaccurate readings; remove old Readings folder (batch 4)
    [capture_loose1.csv, capture_loose2.csv, capture_stationary1.csv, capture_stationary2.csv, capture_stationary3.csv, capture_vibrating1.csv, capture_vibrating10.csv, capture_vibrating2.csv]
2026-08-29 Rewrite README to tell the improving-every-step story, incl. Aug 29 clamp fix
    Updated the README to reflect project progress and changes, including new sections on ideation, hardware, and status.
2026-08-29 Add board-drift systematic error + Aug 29 clamp fix entry
2026-08-29 Add Aug 29 logbook entry: board-drift fix and first full accurate dataset
2026-08-29 Add accurate readings: 0-1 bolts tight (batch 1/6)
    [capture_0vibrating1.csv, capture_0vibrating2.csv, capture_0vibrating3.csv, capture_1vibrating1.csv]
2026-08-29 Add accurate readings: 1-2 bolts tight (batch 2/6)
    [capture_1vibrating2.csv, capture_1vibrating3.csv, capture_2vibrating1.csv, capture_2vibrating2.csv]
2026-08-29 Add accurate readings: 2-3 bolts tight (batch 3/6)
    [capture_2vibrating3.csv, capture_3vibrating1.csv, capture_3vibrating2.csv, capture_3vibrating3.csv]
2026-08-29 Add accurate readings: 4 bolts tight + no-fishplate run 1 (batch 4/6)
    [capture_4vibrating1.csv, capture_4vibrating2.csv, capture_4vibrating3.csv, capture_nofishplate1.csv]
2026-08-29 Add accurate readings: no-fishplate runs 2-3, stationary baselines 1-2 (batch 5/6)
    [capture_nofishplate2.csv, capture_nofishplate3.csv, capture_stationary1.csv, capture_stationary2.csv]
2026-08-29 Add accurate readings: stationary baseline 3 (batch 6/6)
    [capture_stationary3.csv]
2026-08-29 Add without-motor-tight control readings (batch 1/4)
    [capture_3vibrating1.csv, capture_4vibrating1.csv, capture_4vibrating2.csv]
2026-08-29 Add without-motor-tight control readings (batch 2/4)
    [capture_4vibrating3.csv, capture_4vibrating4.csv, capture_4vibrating5.csv]
2026-08-29 Add without-motor-tight control readings (batch 3/4)
    [capture_stationary1.csv, capture_stationary2.csv]
2026-08-29 Add without-motor-tight control readings (batch 4/4)
    [capture_stationary3.csv]
2026-08-29 Add vibration-vs-bolt-state chart from Aug 29 accurate readings
2026-08-29 Add rig photo (rail, motor, sensor board)
2026-09-16 Revise README for clarity and project details
    Updated the README.md to provide a clearer overview of the Rail-Guard project, including its purpose, methodology, and current status.
2026-09-20 Add fft_analysis.py -- FFT tool for vibration captures
    Loads a capture CSV, removes gravity, runs an FFT, and reports dominant frequency, RMS, band energy, and the low/high energy ratio used by classify_tightness.py.
    [fft_analysis.py]
2026-09-20 Add classify_tightness.py for rail-guard analysis
    This script classifies the tightness of rail-guard fishplates based on FFT analysis of vibration data. It determines if the joint is tight or loose using a defined threshold and flags non-vibrating readings.
    [classify_tightness.py]
2026-09-20 Delete code/Accurate Readings/capture_stationary2.csv
    Recorded in an older logging format (different column names, no ax/ay/az) -- not compatible with the current analysis scripts.
    [capture_stationary2.csv]
2026-09-23 Fix README: remove school/program disclosure, restore accurate project description
    The Sept 16 README rewrite (ba3cdd2) had disclosed the school name and city, which violates IRIS anonymity rules, and described hardware/status that doesn't match the rest of the repo (analysis, code, docs, hardware, logbook READMEs). Replaced with an accurate, anonymized description reflecting current status including the FFT ratio threshold work.
2026-09-23 Extend logbook with May-June ideation/build entries and Sept 20 FFT finding
    Added the May 2 - June 27 entries from the paper logbook (ideation through soldering), noted the undocumented gap between 27 June and 7 August, and added a 20 September entry for the FFT band-ratio tight/loose finding. No changes to the existing 7/8/29 August entries.
2026-09-26 Replace full procurement BOM with As-Built BOM only
    Only the components actually in the final device (e.g. 1 vibration motor, not the 3 purchased). The full procurement list stays in the local project folder, not the public repo.
    [RailGuard_BOM_AsBuilt.xlsx]
2026-09-26 Revise BOM file reference in README
    Updated the bill of materials reference to reflect the final build.
2026-09-26 Enhance daq.py with zeroing and CSV improvements
    Updated the daq.py script to include averaging of the first 100 samples for zeroing axis values. Added new columns 'row' and 'seconds' to the CSV output for better data handling.
2026-09-26 Implement experimental bolt-count estimation
    Added experimental bolt-count estimation feature to classify tightness.
    [classify_tightness.py]
2026-09-26 Add live tightness monitoring script
    This script connects to an ESP32 to monitor tightness in real-time, displaying results live on the screen. It utilizes FFT analysis and tuned constants from existing scripts to classify the tightness status based on incoming sensor data.
    [liveclassifytightness.py]
2026-09-26 Add statistical analysis for bolt tightness impact
    This script performs statistical analysis on vibration ratios based on bolt tightness, including ANOVA and Kruskal-Wallis tests.
    [statistical_analysis.py]
2026-09-26 Implement continuous streaming of MPU-6500 data
    This sketch continuously streams vibration data from the MPU-6500 sensor at 1 kHz, allowing for real-time logging. It differs from the capture sketch by printing each sample immediately as it is taken.
    [mpu6050_1khz_stream.ino]
2026-09-27 Update pitch deck: actual bench-build results, embedded demo video, completed-project status
2026-09-27 Update report: restore fine-grained bolt-count row, add ratio table
2026-09-27 Rename Final Schematic.pdf to Previous Schematic.pdf
2026-09-27 Add updated GPIO-remap schematic; rename old one to Previous Schematic
2026-10-12 Update README with current data details
    Removed references to older data and clarified the purpose of the current controlled data.
2026-10-12 Clarify location of 1000 Hz captureUpdate software doc links firmware
    Updated note on 1000 Hz capture firmware location and added reference to the sketch in the main README.
2026-10-12 Update project name in Rail Guard schematic
2026-10-16 Reword Rail-Guard summary
    Claude-Session: https://claude.ai/code/session_01BqRQwu5uN63bfgpCvpCSRe
